RaunakR16/BreathEZ_Auto_CalibratingCPAP/PCB_V0.1/Images/PCB_View_WithComponents.jpg

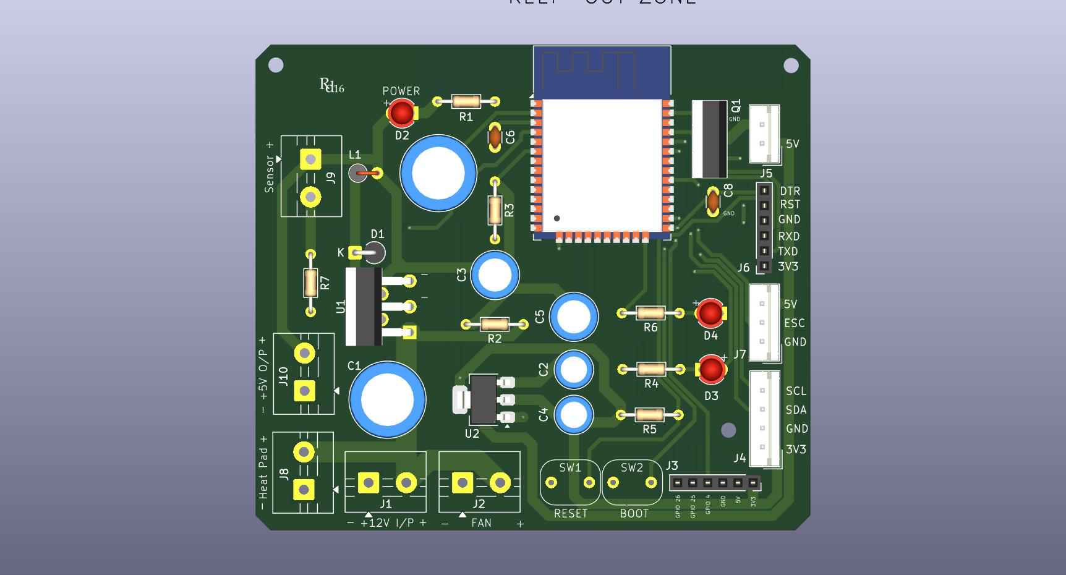
PCB_V0.1/Images/PCB_View_WithComponents.jpg
