RaunakR16/BreathEZ_Auto_CalibratingCPAP/README.md

# BreathEZ
An Auto_CalibratingCPAP
My B.Tech 4th Year project
