RaunakR16/BreathEZ_Auto_CalibratingCPAP/SensorCalibration/SensorData/Grage_1_FilterPaper_17_11_25/sensor_data1.csv

Temperature (°C) | Humidity (%) | Paper Sensor Value
26.20 | 56.00 | 88
26.20 | 57.00 | 0
26.20 | 58.00 | 0
26.20 | 57.00 | 0
26.20 | 57.00 | 57
26.20 | 57.00 | 220
26.20 | 57.00 | 581
26.20 | 57.00 | 1023
26.20 | 58.00 | 1023
26.20 | 58.00 | 1023
26.20 | 58.00 | 1023
26.20 | 58.00 | 878
26.20 | 58.00 | 564
26.20 | 58.00 | 173
26.20 | 58.00 | 0
26.20 | 58.00 | 0
26.20 | 59.00 | 0
26.20 | 59.00 | 42
26.20 | 59.00 | 209
26.20 | 59.00 | 581
26.20 | 60.00 | 1005
26.20 | 60.00 | 1023
26.20 | 61.00 | 1023
26.20 | 61.00 | 1023
26.20 | 62.00 | 927
26.20 | 62.00 | 501
26.20 | 63.00 | 0
26.20 | 64.00 | 0
26.20 | 64.00 | 0
26.20 | 66.00 | 9
26.20 | 68.00 | 87
26.20 | 69.00 | 380
26.20 | 71.00 | 989
26.70 | 73.00 | 1023
26.70 | 75.00 | 1023
26.70 | 77.00 | 1023
26.70 | 79.00 | 1002
26.70 | 81.00 | 580
27.10 | 84.00 | 0
27.10 | 86.00 | 0
27.60 | 89.00 | 0
27.60 | 90.00 | 63
28.00 | 91.00 | 647
28.00 | 92.00 | 1023
28.50 | 93.00 | 1023
28.50 | 94.00 | 1023
28.50 | 95.00 | 614
28.90 | 96.00 | 0
28.90 | 98.00 | 0
29.30 | 98.00 | 0
29.30 | 98.00 | 187
29.80 | 98.00 | 1023
29.80 | 98.00 | 1023
30.20 | 98.00 | 1023
30.20 | 98.00 | 943
30.20 | 98.00 | 9
30.80 | 98.00 | 0
30.80 | 98.00 | 0
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
