RaunakR16/BreathEZ_Auto_CalibratingCPAP/SensorCalibration/SensorData/Grage_1_FilterPaper_17_11_25/sensor_data3.csv

Temperature (°C) | Humidity (%) | Paper Sensor Value
26.20 | 65.00 | 1010
26.20 | 66.00 | 863
26.20 | 67.00 | 595
26.20 | 68.00 | 1023
26.40 | 69.00 | 525
26.50 | 69.00 | 1023
26.70 | 69.00 | 713
26.70 | 69.00 | 812
26.70 | 70.00 | 991
26.70 | 70.00 | 552
26.70 | 70.00 | 1023
26.70 | 71.00 | 529
26.70 | 71.00 | 1023
26.70 | 72.00 | 753
26.70 | 72.00 | 708
26.70 | 73.00 | 1023
26.70 | 73.00 | 473
26.70 | 75.00 | 1023
26.70 | 77.00 | 774
26.70 | 79.00 | 647
26.70 | 81.00 | 1023
27.10 | 83.00 | 573
27.10 | 85.00 | 986
27.10 | 88.00 | 951
27.60 | 90.00 | 638
27.60 | 91.00 | 1023
28.00 | 92.00 | 746
28.50 | 93.00 | 983
28.50 | 94.00 | 1005
28.90 | 95.00 | 771
29.00 | 96.00 | 1023
29.30 | 98.00 | 866
29.80 | 98.00 | 930
29.80 | 98.00 | 1023
29.80 | 98.00 | 821
30.20 | 98.00 | 1023
30.20 | 98.00 | 1011
30.80 | 98.00 | 868
30.80 | 98.00 | 1023
30.80 | 98.00 | 963
30.80 | 98.00 | 922
30.80 | 98.00 | 1023
30.80 | 98.00 | 898
30.80 | 98.00 | 1023
30.80 | 98.00 | 1010
30.70 | 98.00 | 904
30.20 | 98.00 | 1023
30.20 | 98.00 | 912
30.20 | 98.00 | 1001
30.20 | 98.00 | 1023
29.80 | 98.00 | 890
29.80 | 98.00 | 1023
29.80 | 98.00 | 999
29.80 | 98.00 | 910
29.30 | 98.00 | 1023
29.30 | 98.00 | 984
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
