RaunakR16/BreathEZ_Auto_CalibratingCPAP/breathingPatternAnalysis/Graphes/AdrikPaul,M12.png

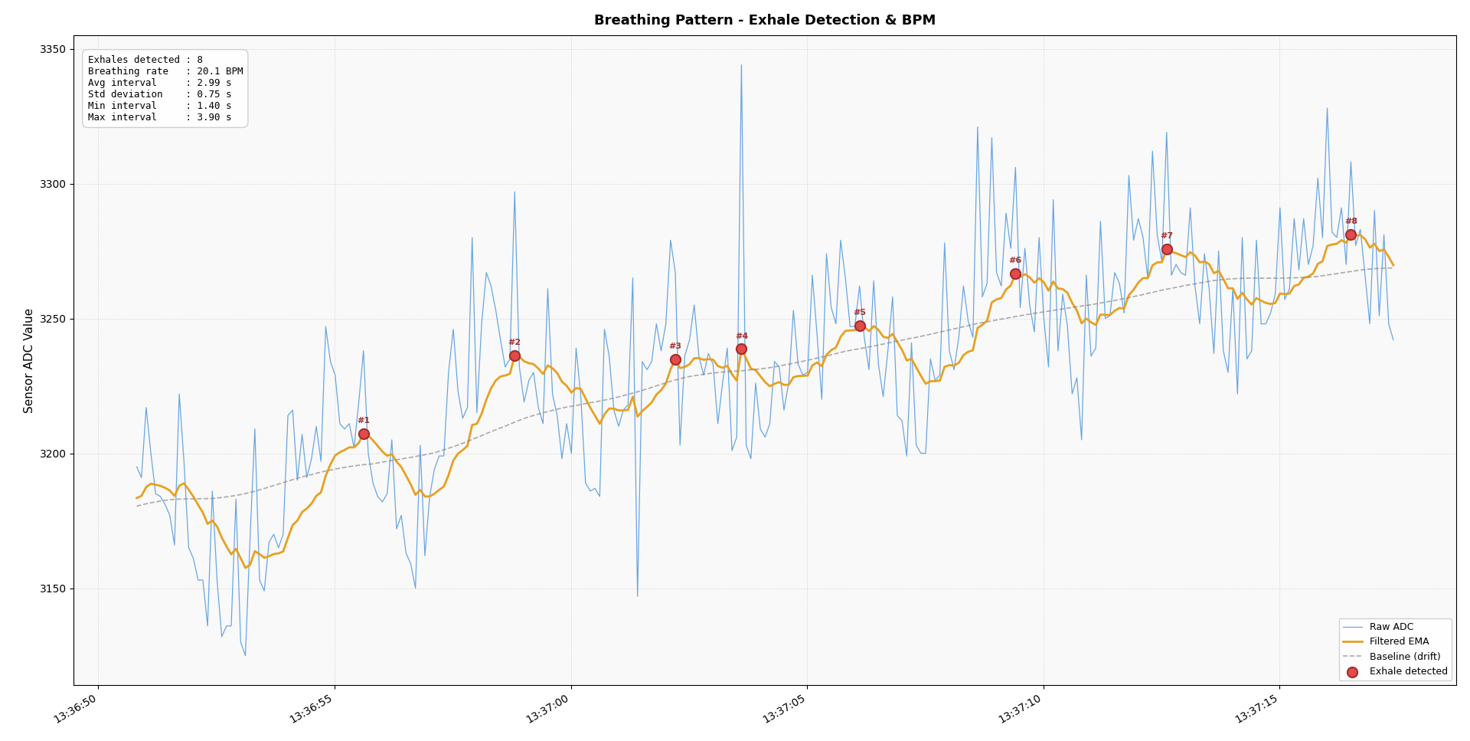
breathingPatternAnalysis/Graphes/AdrikPaul,M12.png
