RaunakR16/BreathEZ_Auto_CalibratingCPAP/breathingPatternAnalysis/Graphes/ArchanaSarkar,F72.png

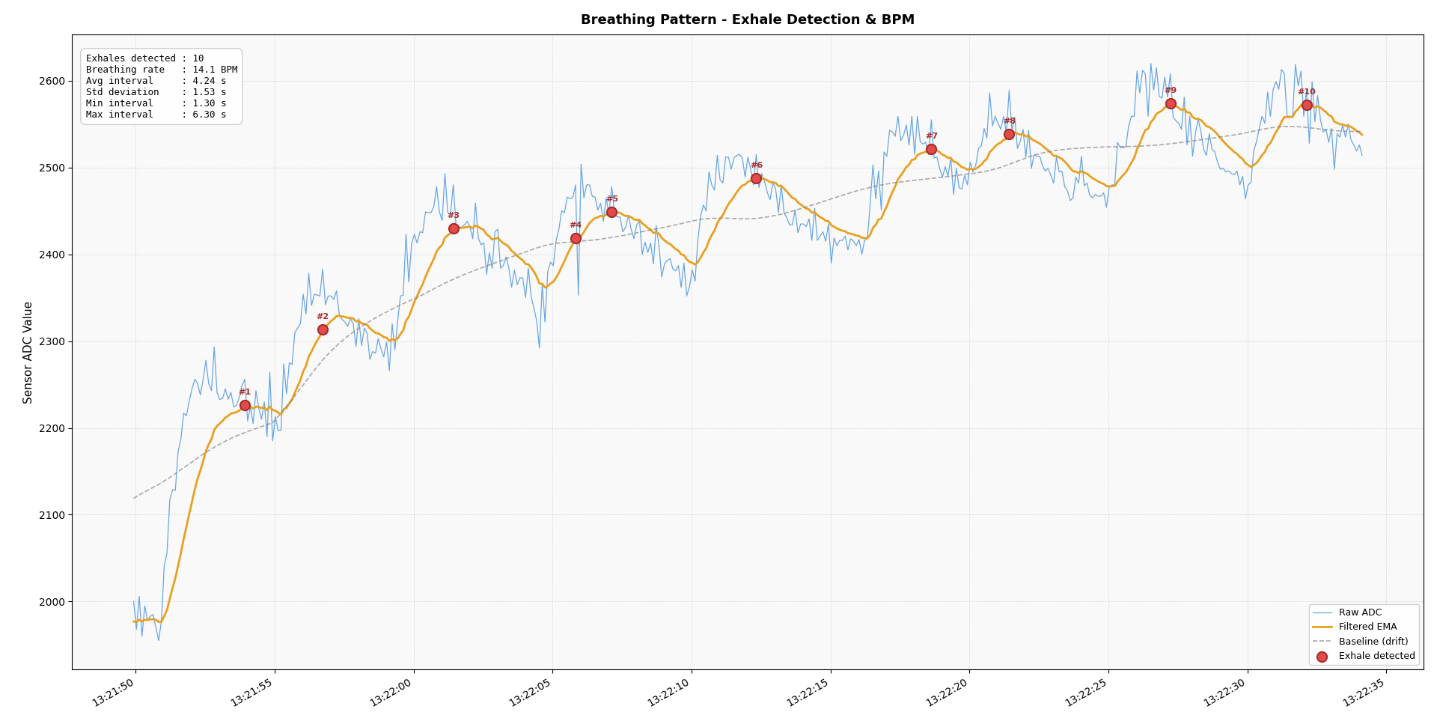
breathingPatternAnalysis/Graphes/ArchanaSarkar,F72.png
