RaunakR16/BreathEZ_Auto_CalibratingCPAP/breathingPatternAnalysis/Graphes/MamppiPaul,F42.png

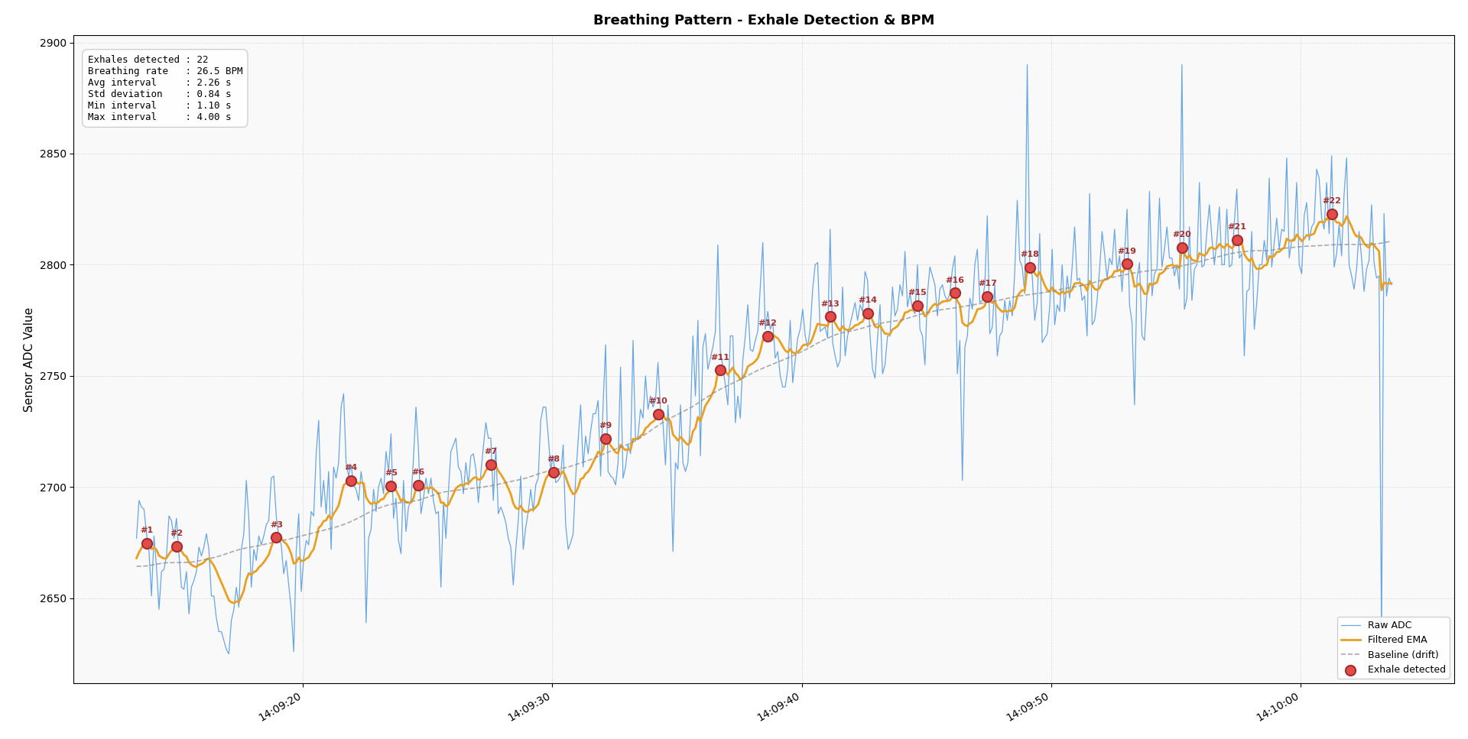
breathingPatternAnalysis/Graphes/MamppiPaul,F42.png
