RaunakR16/BreathEZ_Auto_CalibratingCPAP/breathingPatternAnalysis/Graphes/ProloyPal,M35.png

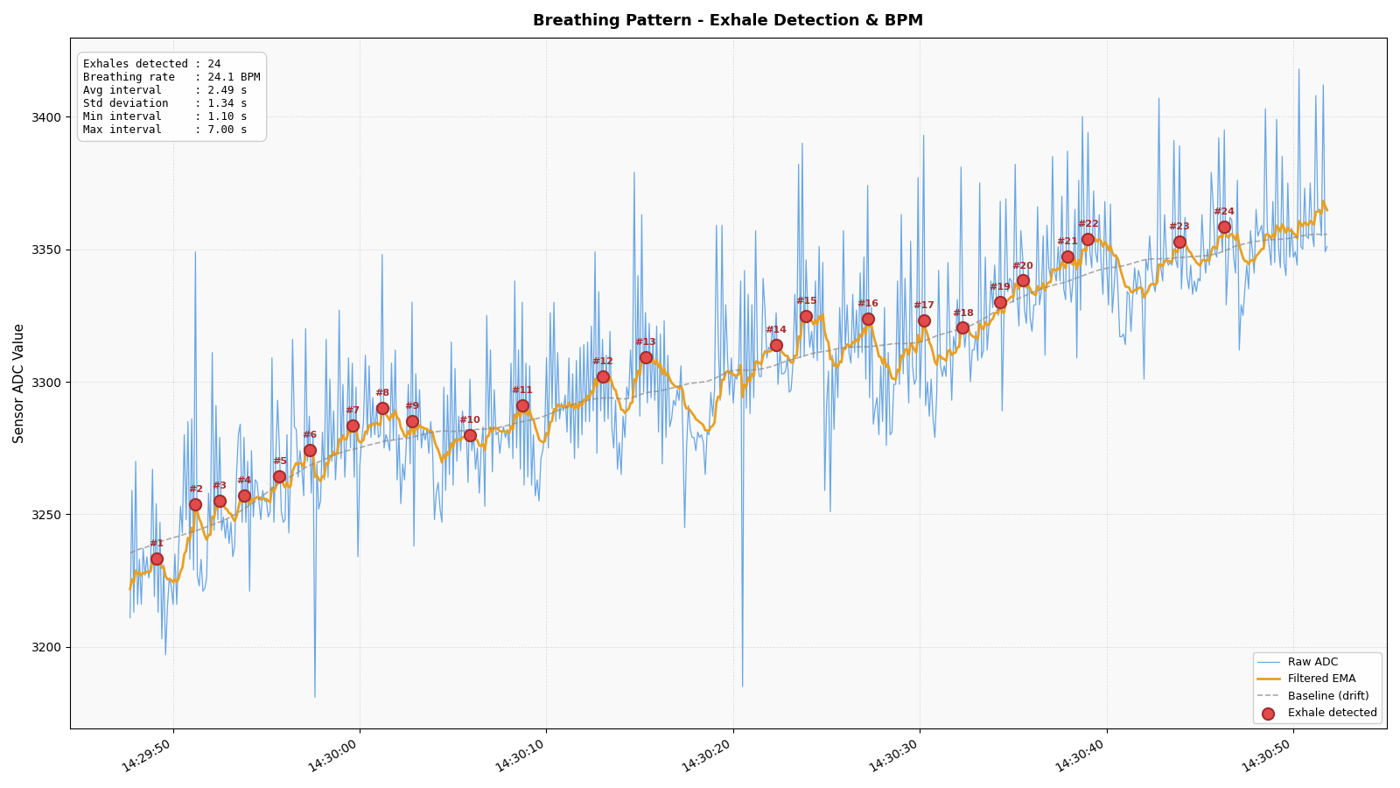
breathingPatternAnalysis/Graphes/ProloyPal,M35.png
