RaunakR16/BreathEZ_Auto_CalibratingCPAP/breathingPatternAnalysis/Graphes/RaunakDas,M22.png

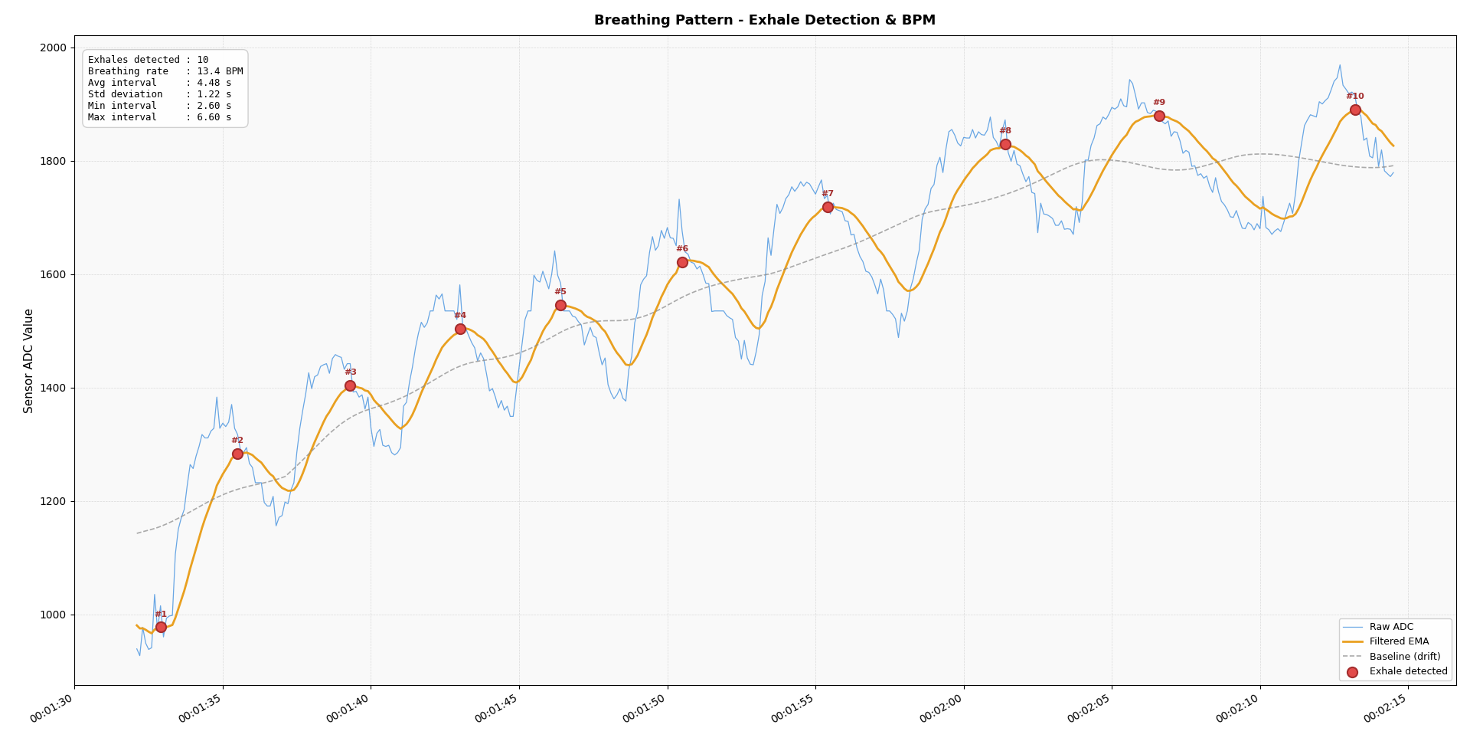
breathingPatternAnalysis/Graphes/RaunakDas,M22.png
