RaunakR16/BreathEZ_Auto_CalibratingCPAP/breathingPatternAnalysis/Graphes/SangitaBhuya,F64.png

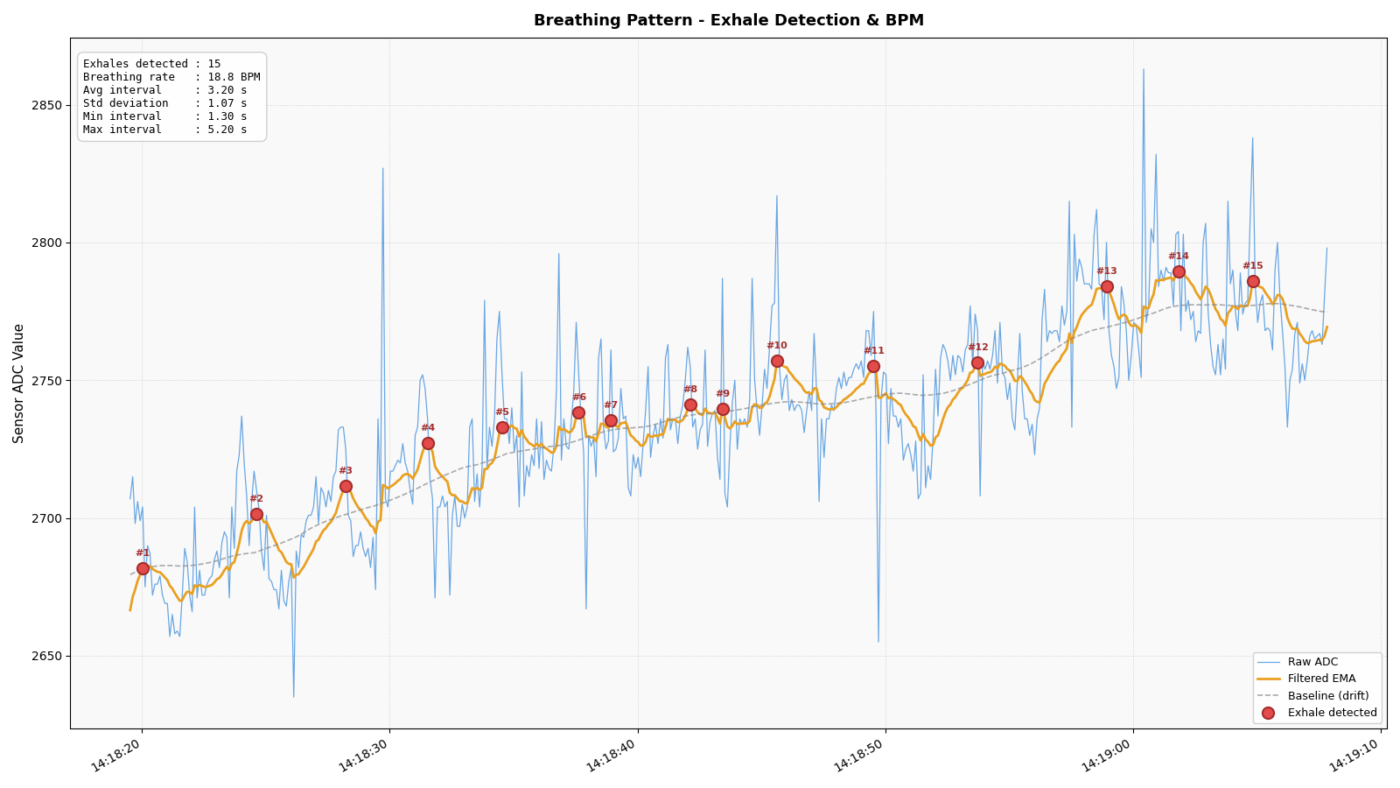
breathingPatternAnalysis/Graphes/SangitaBhuya,F64.png
