RaunakR16/BreathEZ_Auto_CalibratingCPAP/breathingPatternAnalysis/Graphes/SankarPaul,M62.png

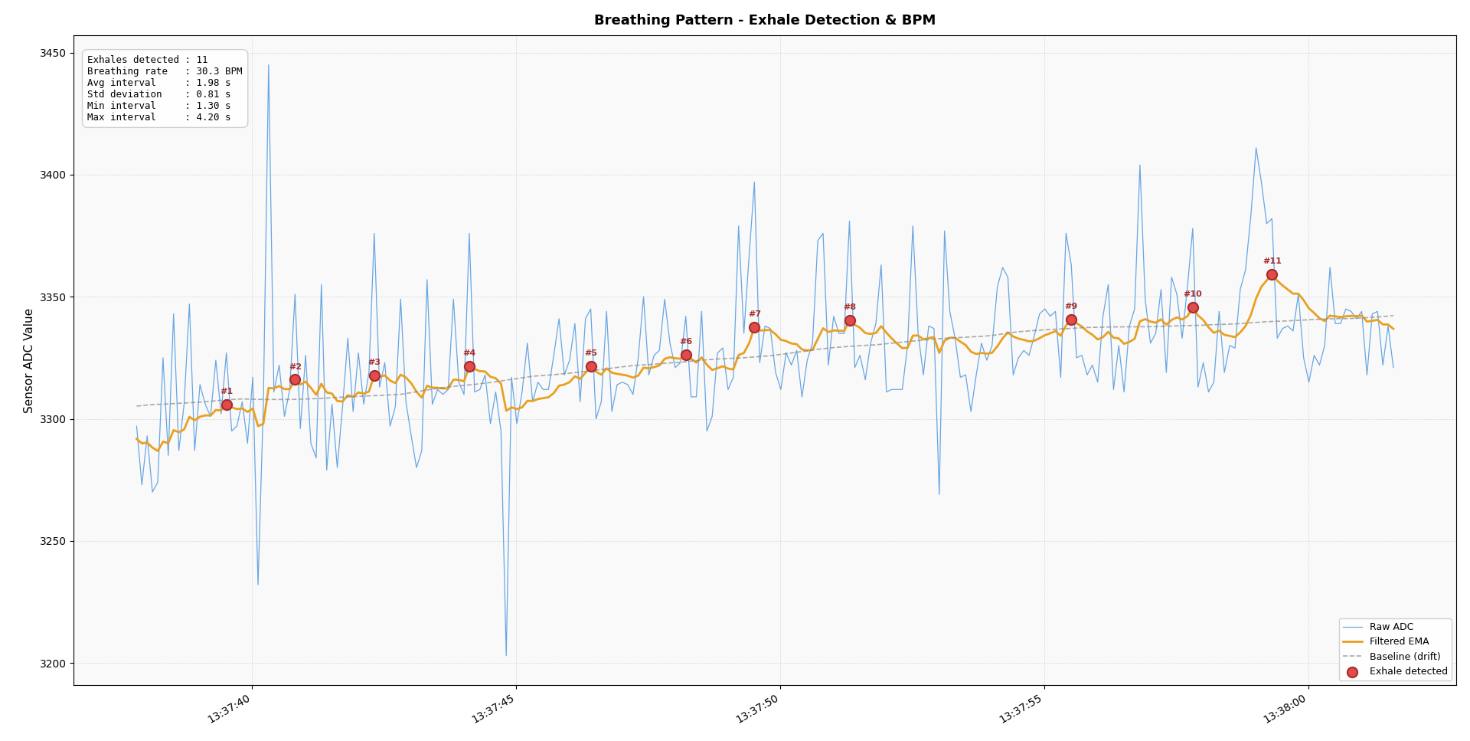
breathingPatternAnalysis/Graphes/SankarPaul,M62.png
