RaunakR16/BreathEZ_Auto_CalibratingCPAP/IMAGES/FlowChart.png

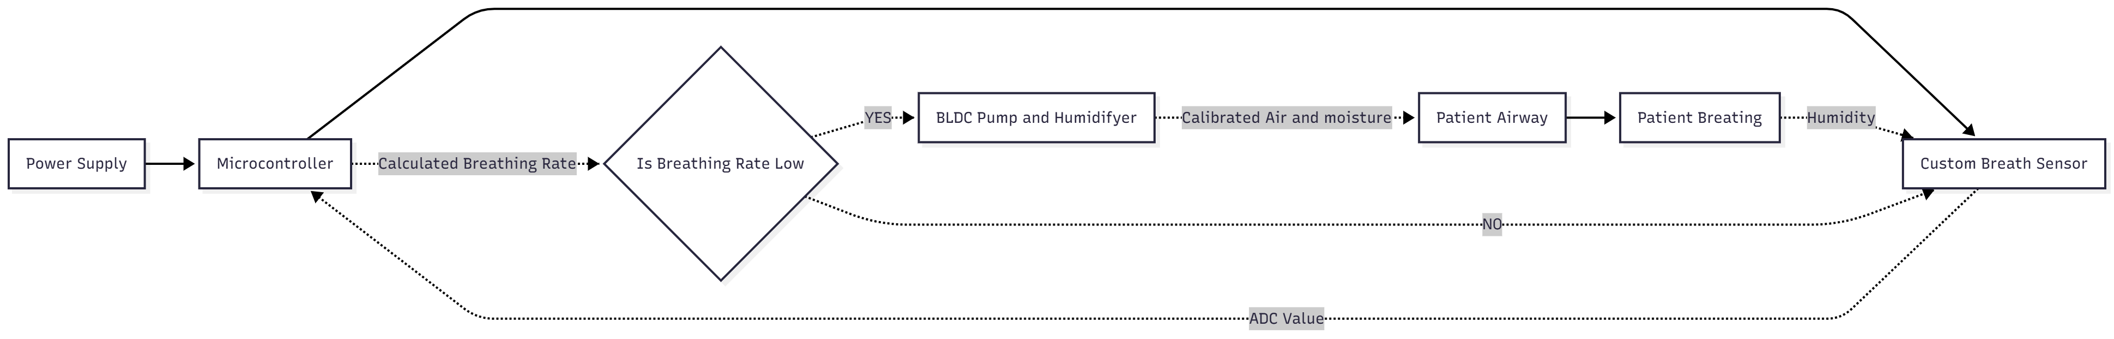
IMAGES/FlowChart.png
