RaunakR16/BreathEZ_Auto_CalibratingCPAP/IMAGES/Graphes/G1HMP.png

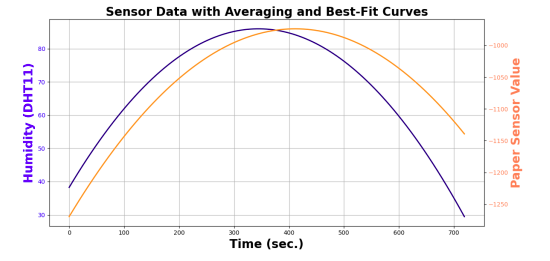
IMAGES/Graphes/G1HMP.png
