RaunakR16/BreathEZ_Auto_CalibratingCPAP/IMAGES/Graphes/G3HMP.png

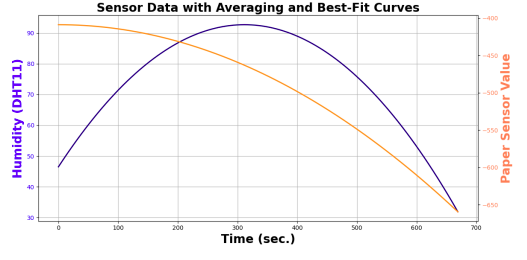
IMAGES/Graphes/G3HMP.png
