RaunakR16/BreathEZ_Auto_CalibratingCPAP/IMAGES/Graphes/G4NP.png

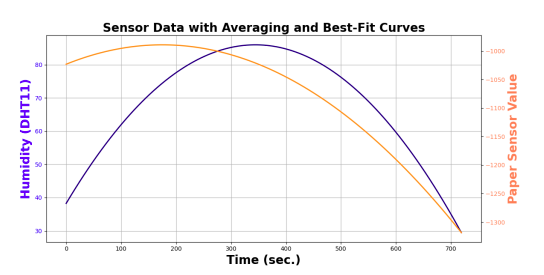
IMAGES/Graphes/G4NP.png
