RaunakR16/BreathEZ_Auto_CalibratingCPAP/IMAGES/Graphes/no heat pad.png

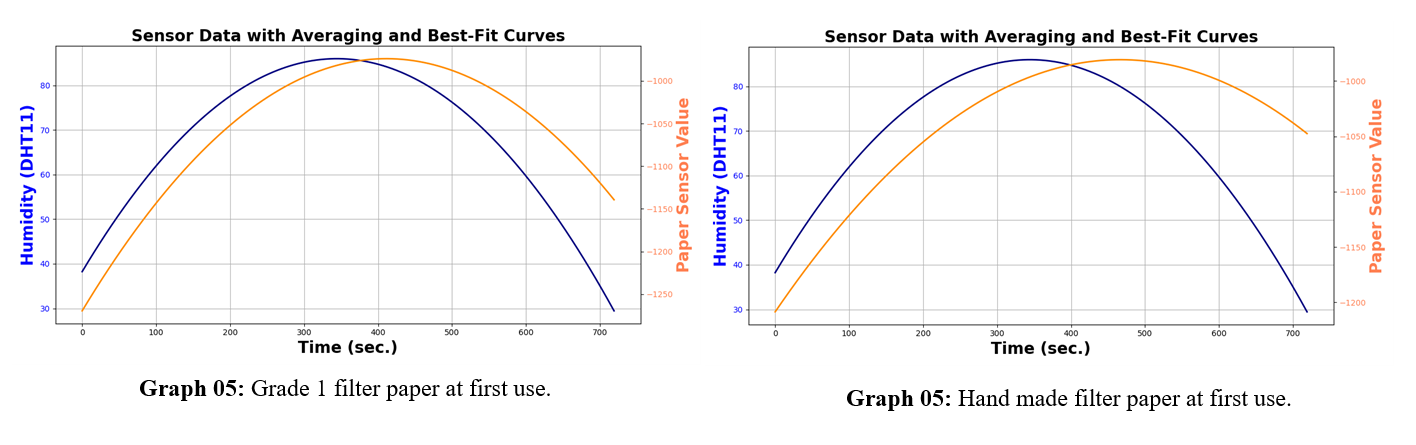
IMAGES/Graphes/no heat pad.png
