RaunakR16/BreathEZ_Auto_CalibratingCPAP/IMAGES/Graphes/Screenshot 2025-11-19 004111.png

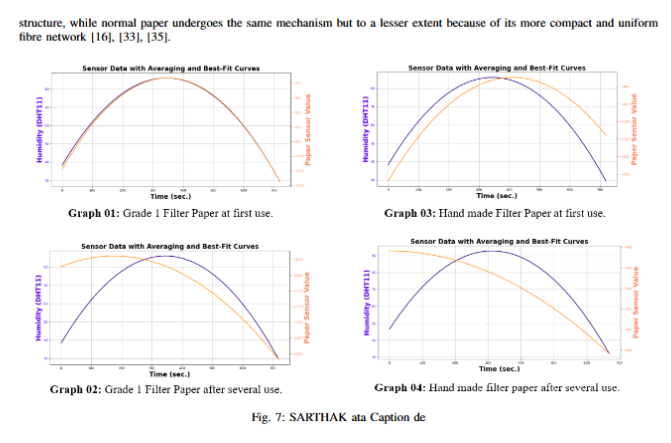
IMAGES/Graphes/Screenshot 2025-11-19 004111.png
