RaunakR16/BreathEZ_Auto_CalibratingCPAP/IMAGES/Graphes/with_heat_Pad.png

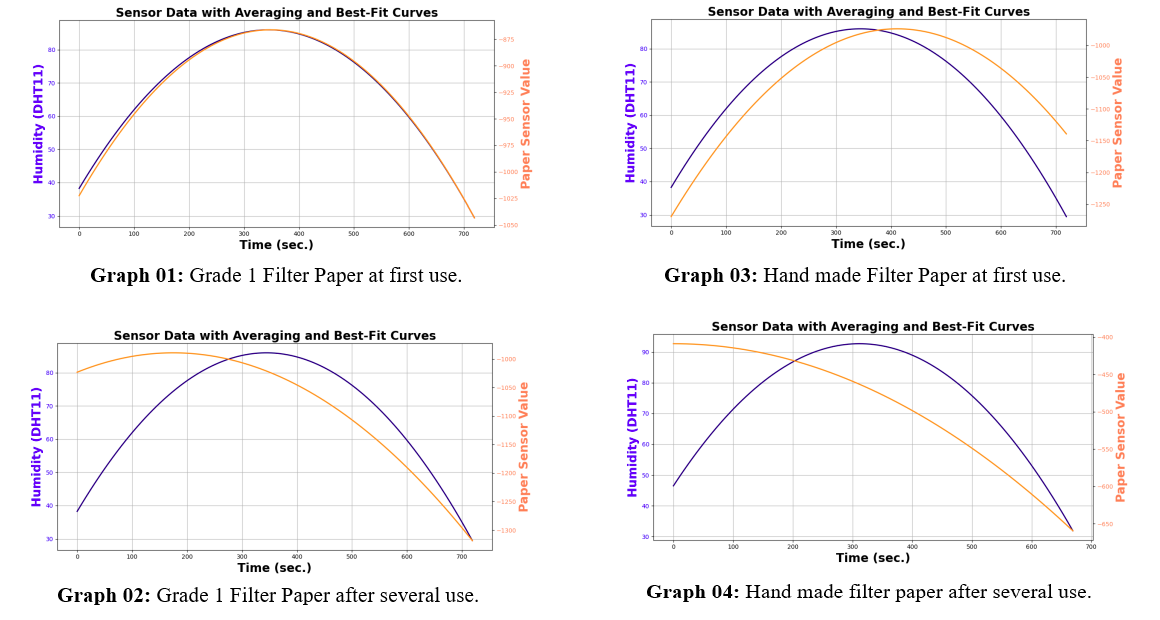
IMAGES/Graphes/with_heat_Pad.png
