RaunakR16/BreathEZ_Auto_CalibratingCPAP/IMAGES/HeatPad.png

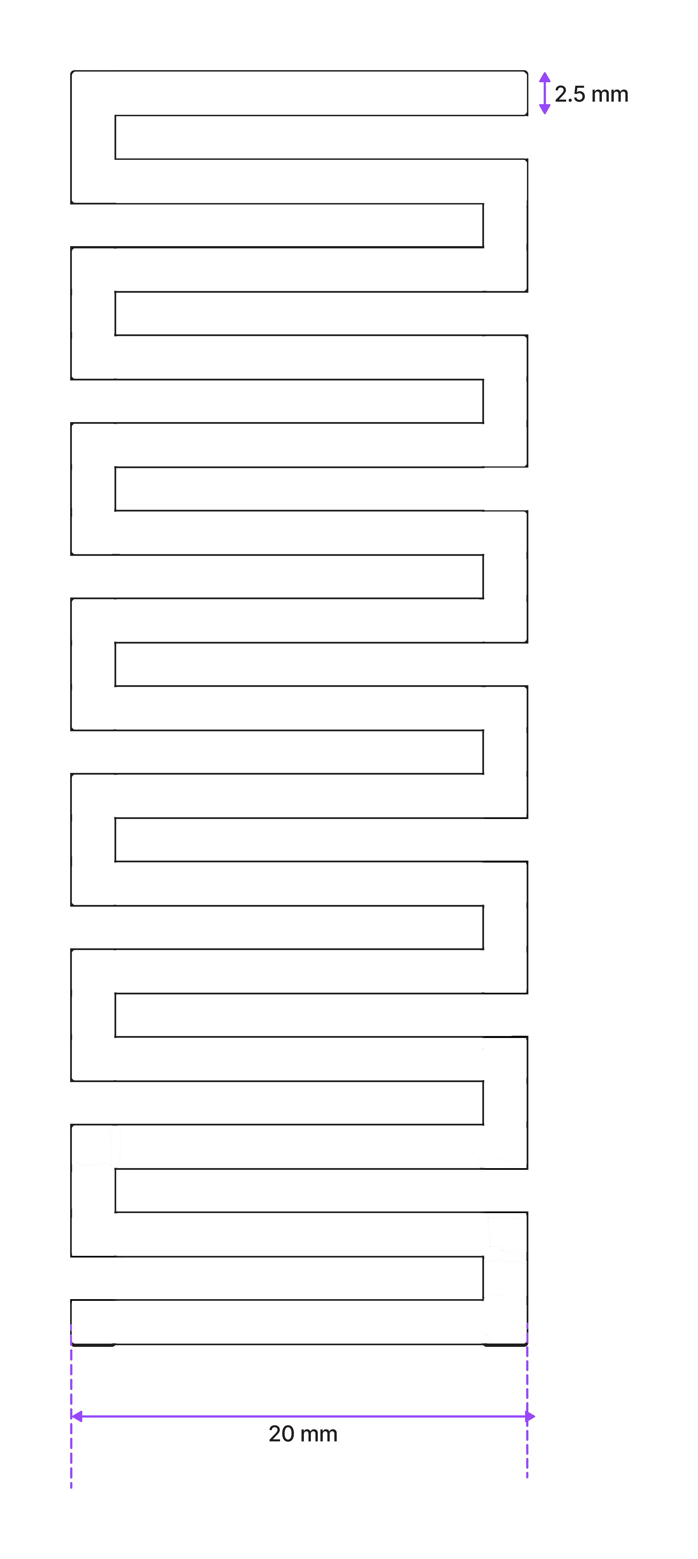
IMAGES/HeatPad.png
