RaunakR16/BreathEZ_Auto_CalibratingCPAP/IMAGES/image.png

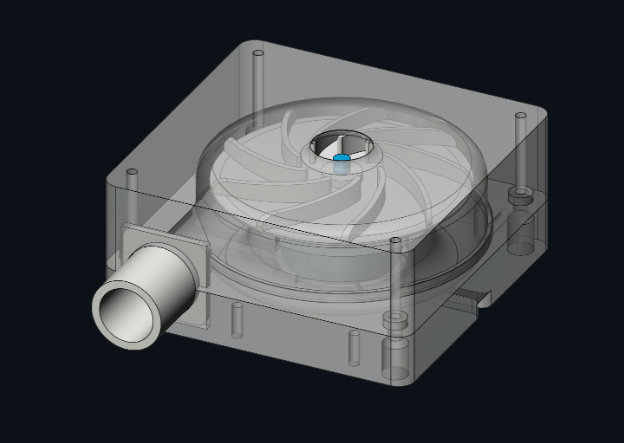
IMAGES/image.png
