RaunakR16/BreathEZ_Auto_CalibratingCPAP/IMAGES/Microscopic_Images/cloth_used/WhatsApp Image 2025-11-13 at 3.08.39 PM (2).jpeg

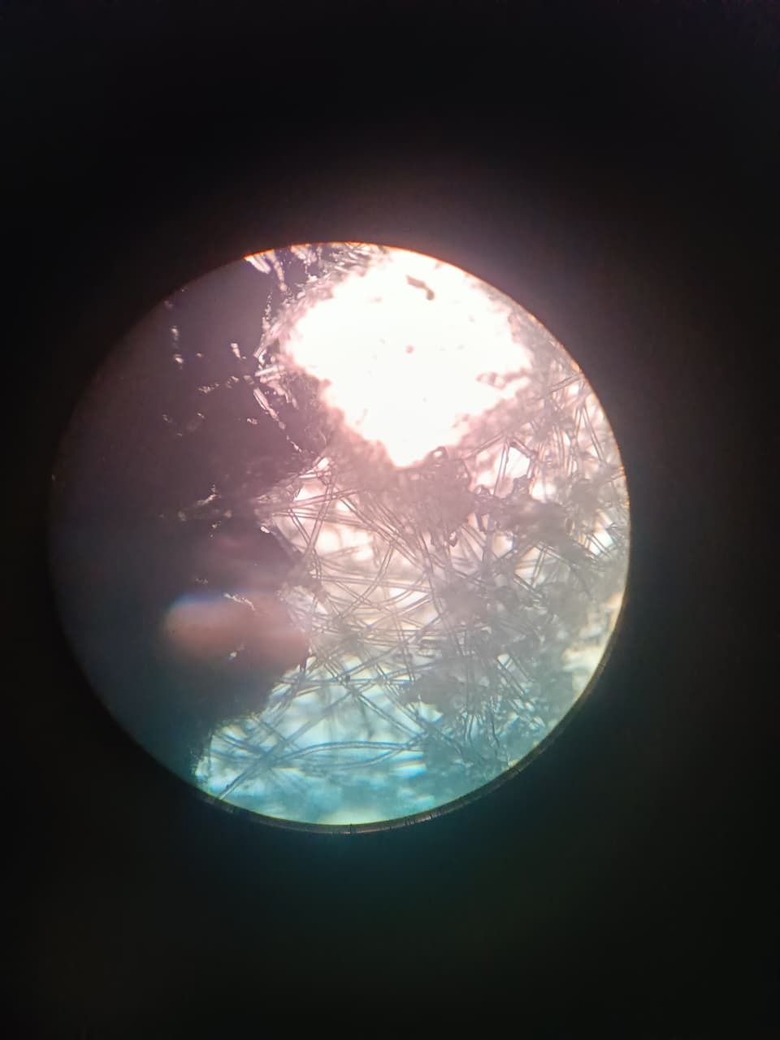
IMAGES/Microscopic_Images/cloth_used/WhatsApp Image 2025-11-13 at 3.08.39 PM (2).jpeg
