RaunakR16/BreathEZ_Auto_CalibratingCPAP/IMAGES/Microscopic_Images/maskpaper_nosalt/WhatsApp Image 2025-11-13 at 3.13.03 PM (1).jpeg

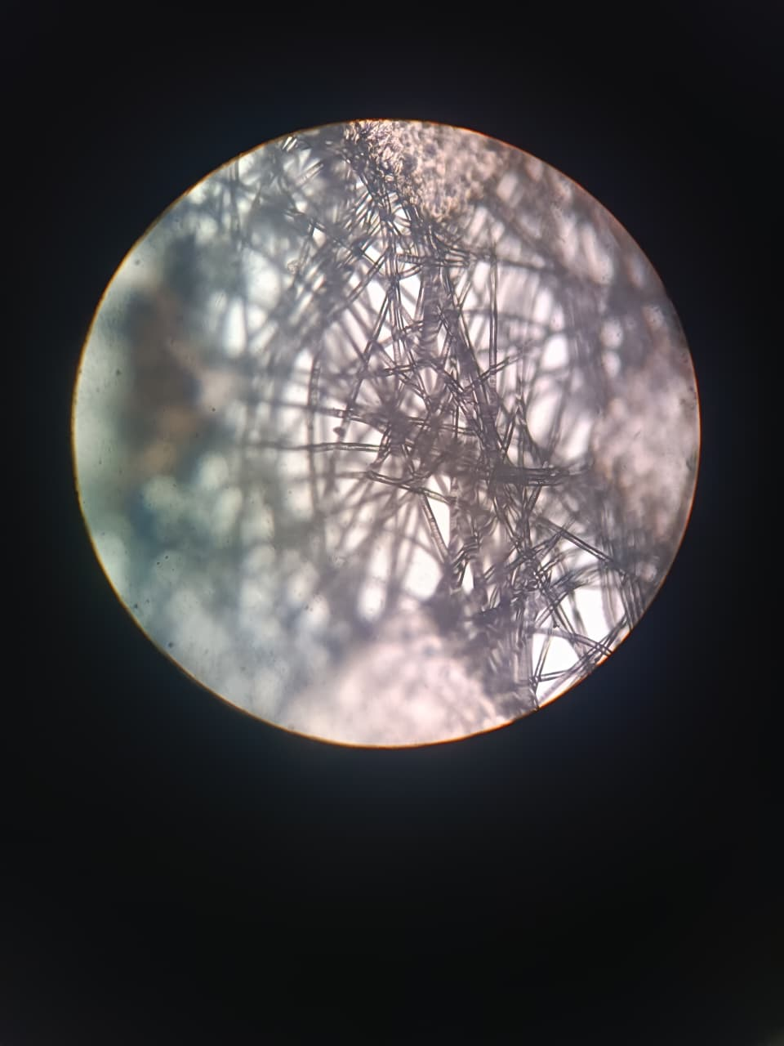
IMAGES/Microscopic_Images/maskpaper_nosalt/WhatsApp Image 2025-11-13 at 3.13.03 PM (1).jpeg
