RaunakR16/BreathEZ_Auto_CalibratingCPAP/IMAGES/Microscopic_Images/used_paper_sensor/WhatsApp Image 2025-11-13 at 3.00.08 PM.jpeg

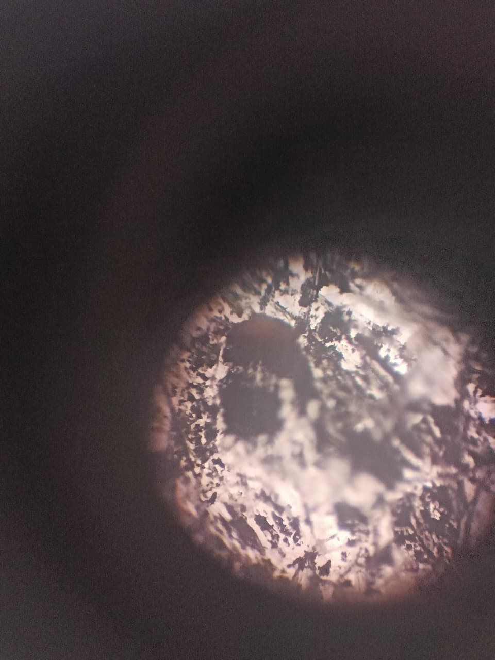
IMAGES/Microscopic_Images/used_paper_sensor/WhatsApp Image 2025-11-13 at 3.00.08 PM.jpeg
