RaunakR16/BreathEZ_Auto_CalibratingCPAP/IMAGES/no_heat_paper/G2_HMP.png

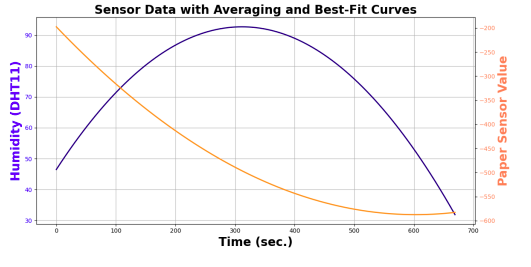
IMAGES/no_heat_paper/G2_HMP.png
