RaunakR16/BreathEZ_Auto_CalibratingCPAP/IMAGES/no_heat_paper/G3NP.png

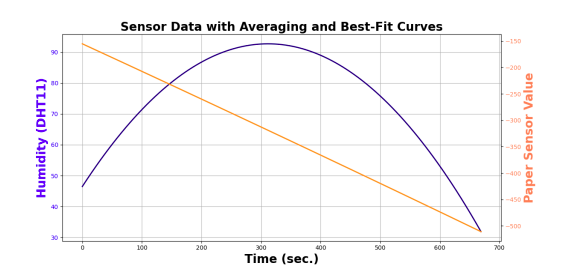
IMAGES/no_heat_paper/G3NP.png
