RaunakR16/BreathEZ_Auto_CalibratingCPAP/IMAGES/no_heat_paper/Graph1_NormalPaper.png

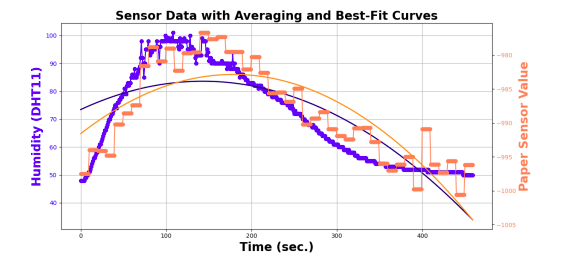
IMAGES/no_heat_paper/Graph1_NormalPaper.png
