RaunakR16/BreathEZ_Auto_CalibratingCPAP/IMAGES/Pump1.png

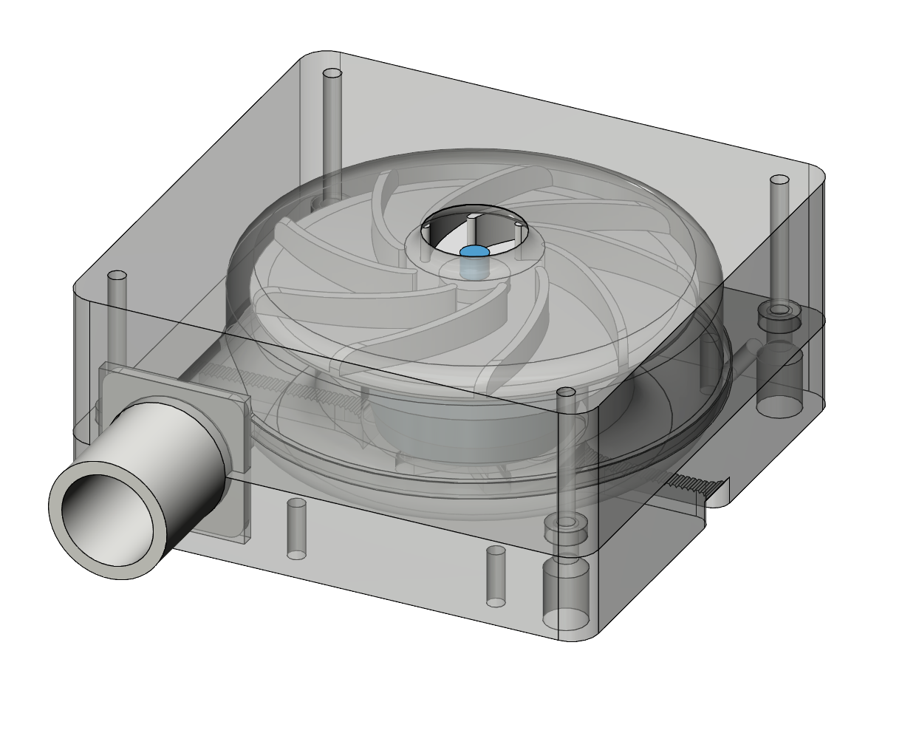
IMAGES/Pump1.png
