RaunakR16/BreathEZ_Auto_CalibratingCPAP/IMAGES/Pump.png

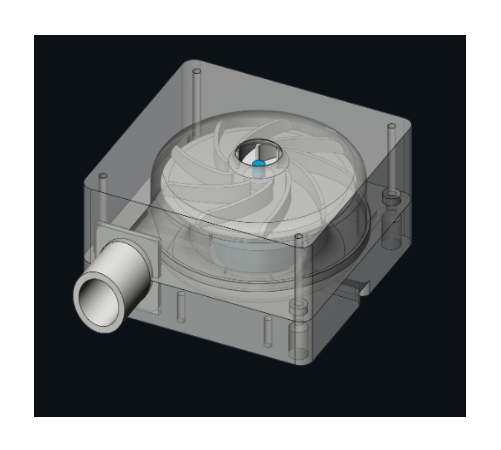
IMAGES/Pump.png
