RaunakR16/BreathEZ_Auto_CalibratingCPAP/IMAGES/tank/tank100.jpg

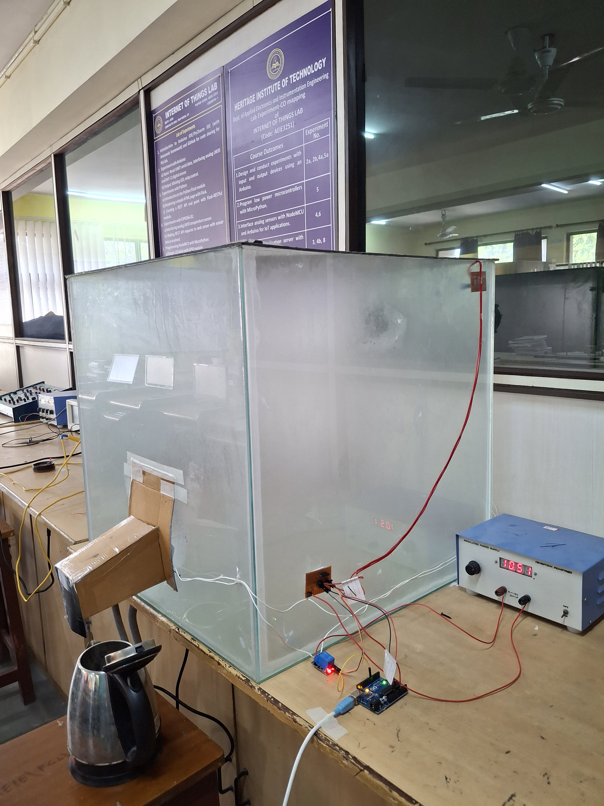
IMAGES/tank/tank100.jpg
