RaunakR16/BreathEZ_Auto_CalibratingCPAP/IMAGES/with_heat_pad/G2NP.png

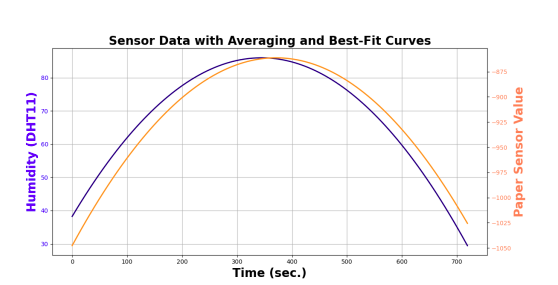
IMAGES/with_heat_pad/G2NP.png
