RaunakR16/BreathEZ_Auto_CalibratingCPAP/PCB_V0.1/Images/ATmega328p_Draft.png

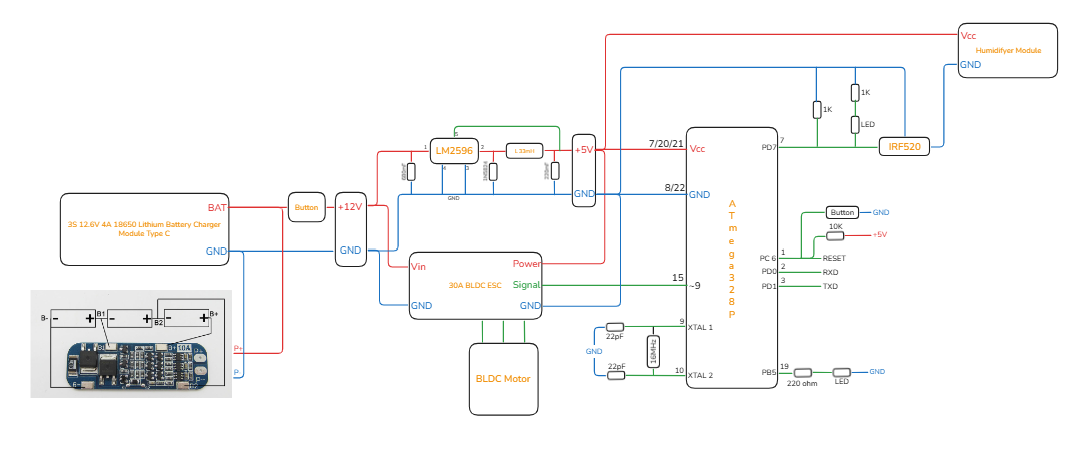
PCB_V0.1/Images/ATmega328p_Draft.png
