RaunakR16/BreathEZ_Auto_CalibratingCPAP/PCB_V0.1/Images/ESP32-WROOM-32_Draft.png

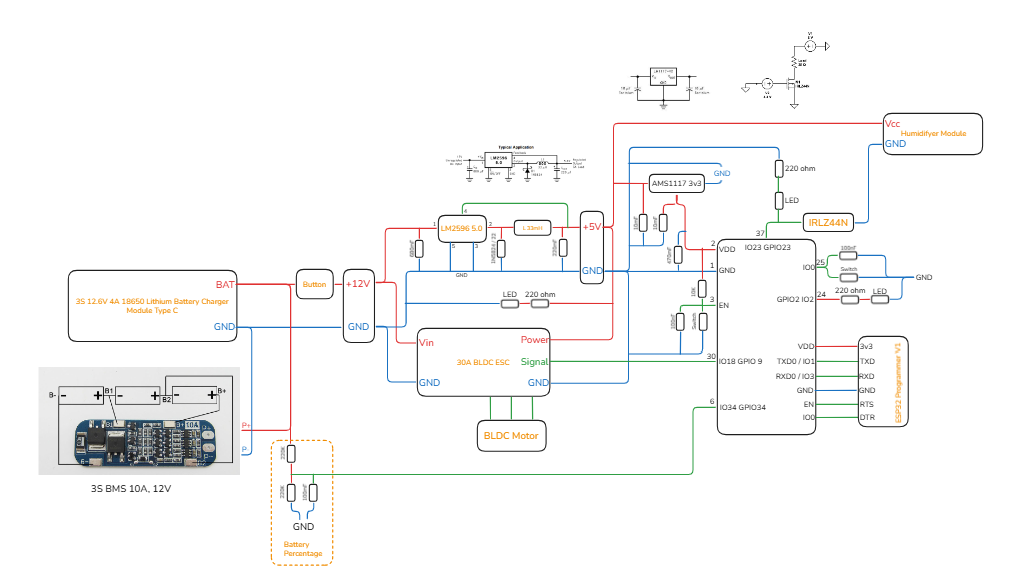
PCB_V0.1/Images/ESP32-WROOM-32_Draft.png
