RaunakR16/BreathEZ_Auto_CalibratingCPAP/PCB_V0.1/Images/PCB_View.jpg

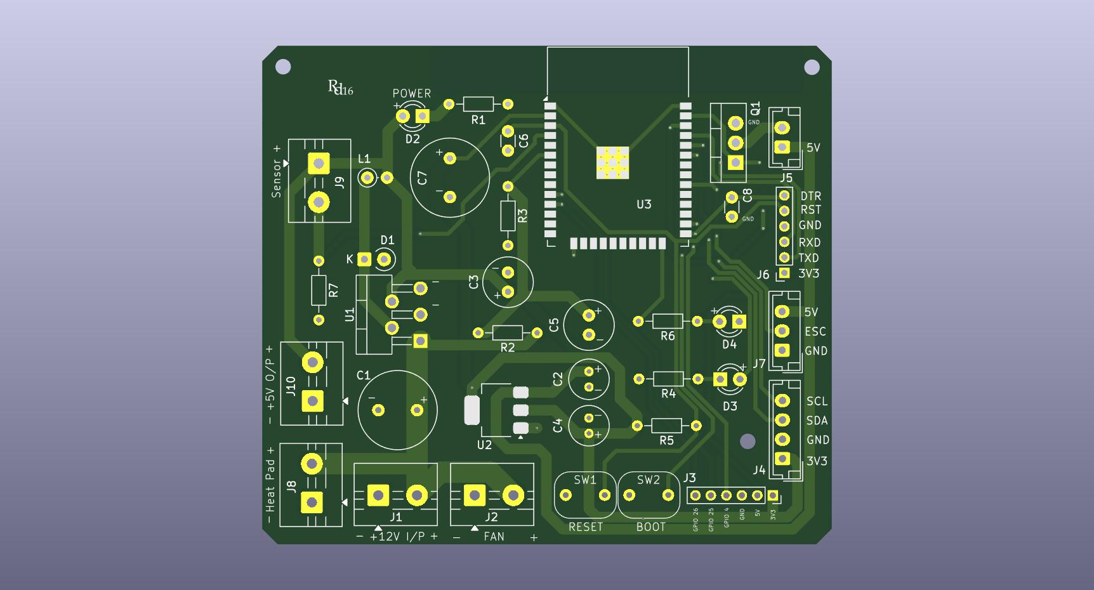
PCB_V0.1/Images/PCB_View.jpg
