RaunakR16/BreathEZ_Auto_CalibratingCPAP/3D Prints/BreathEZ_V1.1/pressure_sensor_assy_HX710B.step

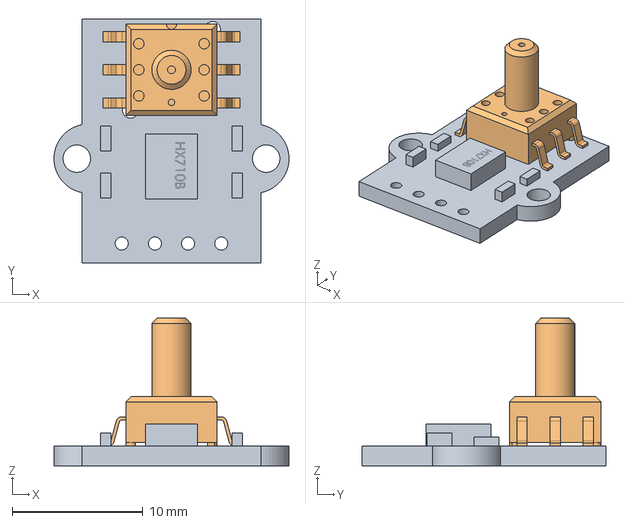
[picture p85: CAD file, 2026-05-27]
3D Prints/BreathEZ_V1.1/pressure_sensor_assy_HX710B.step
18.0 x 18.7 x 11.3 mm
pressure_sensor_pcb_HX710B
MPS-3117_По умолчанию
