RaunakR16/BreathEZ_Auto_CalibratingCPAP/3D Prints/BreathEZ_V1.1/Pantalla OLED 0.96'' 128x64.step

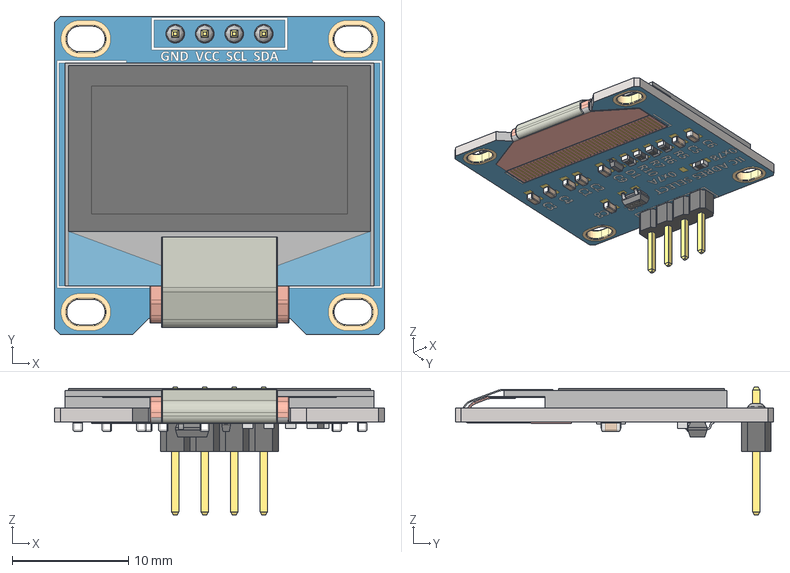
[picture p86: CAD file, 2026-05-27]
3D Prints/BreathEZ_V1.1/Pantalla OLED 0.96'' 128x64.step
28.4 x 27.4 x 11.0 mm
SOT-23_TOR
RES_CR16_MTK_1 x 4
RES_CR16_MTK
SOD323F_DIO
