RaunakR16/BreathEZ_Auto_CalibratingCPAP/3D Prints/BreathEZ_V1.1/4S BMS Charger.step

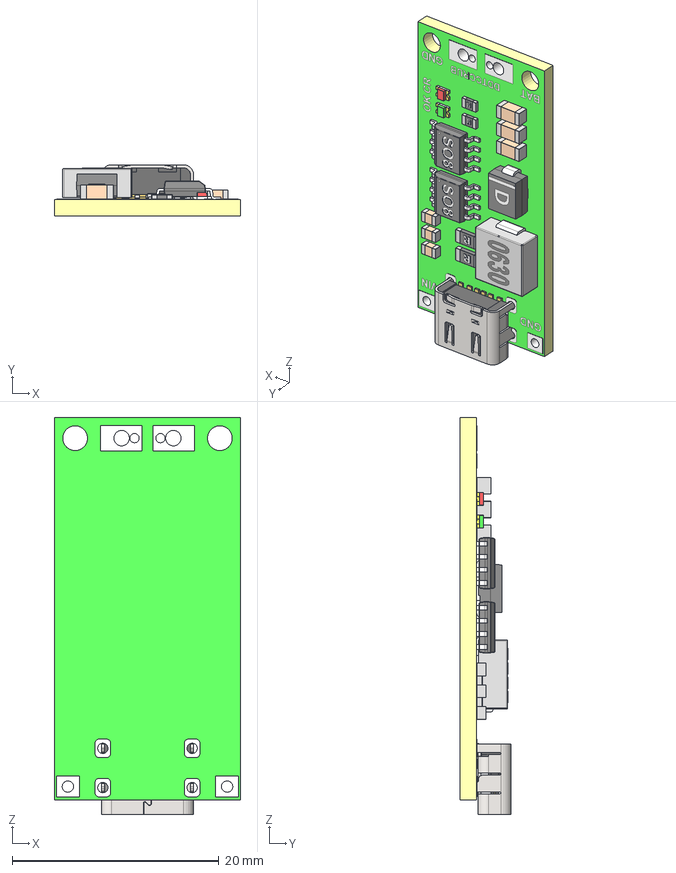
[picture p87: CAD file, 2026-05-27]
3D Prints/BreathEZ_V1.1/4S BMS Charger.step
18.0 x 4.98 x 38.4 mm
