RaunakR16/BreathEZ_Auto_CalibratingCPAP/3D Prints/BreathEZ_V1.1/Hold_21700-4p.step

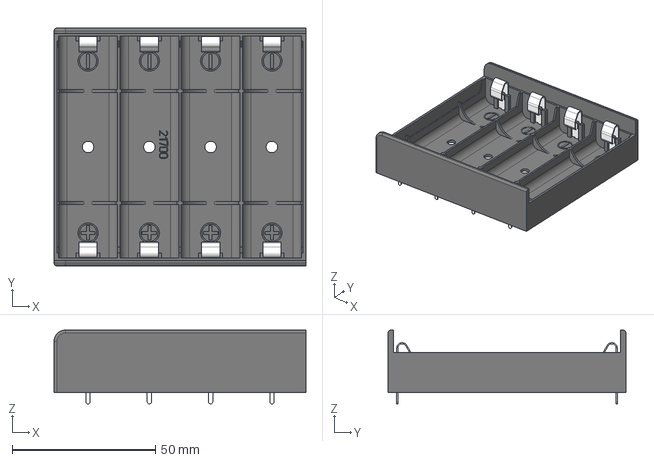
[picture p88: CAD file, 2026-05-27]
3D Prints/BreathEZ_V1.1/Hold_21700-4p.step
88.0 x 83.0 x 25.8 mm
Hold_21700_Con x 8
Hold_21700-4p
