RaunakR16/BreathEZ_Auto_CalibratingCPAP/3D Prints/BreathEZ_V1.1/Button.step

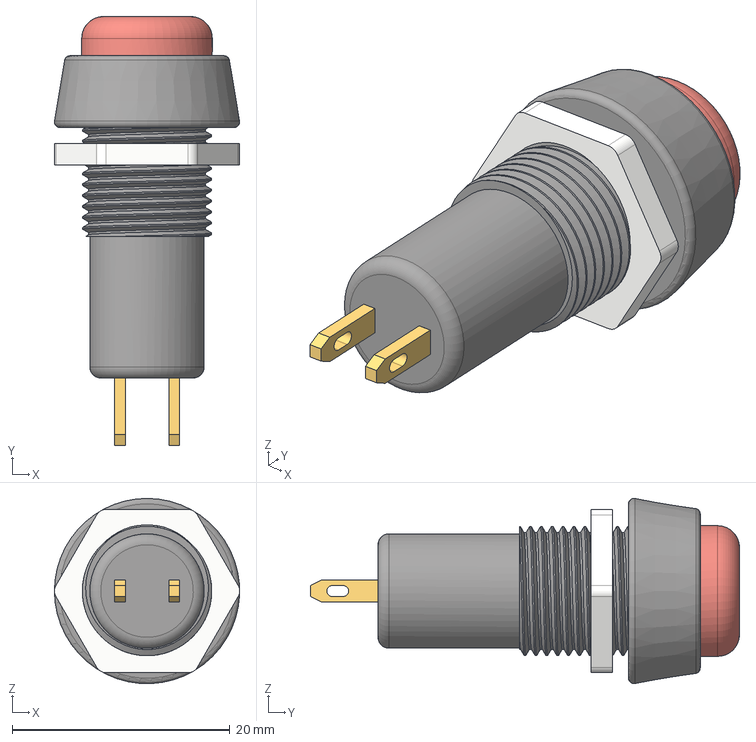
[picture p89: CAD file, 2026-05-27]
3D Prints/BreathEZ_V1.1/Button.step
17.0 x 39.4 x 17.0 mm
