RaunakR16/BreathEZ_Auto_CalibratingCPAP/3D Prints/BreathEZ_V1.1/BLDC_Pump.step

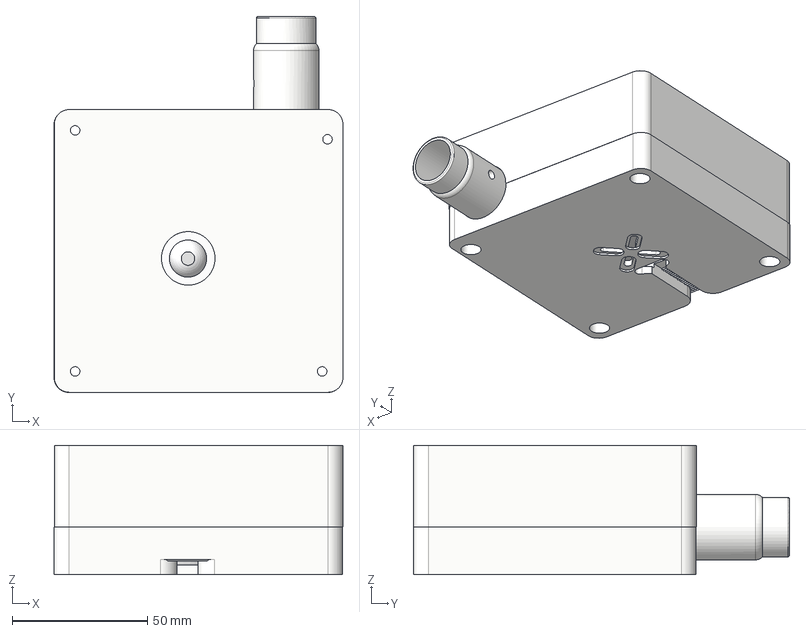
[picture p90: CAD file, 2026-05-27]
3D Prints/BreathEZ_V1.1/BLDC_Pump.step
106.8 x 139.0 x 47.7 mm
