RaunakR16/BreathEZ_Auto_CalibratingCPAP/3D Prints/BreathEZ_V1.0/BLDC_Pump.step

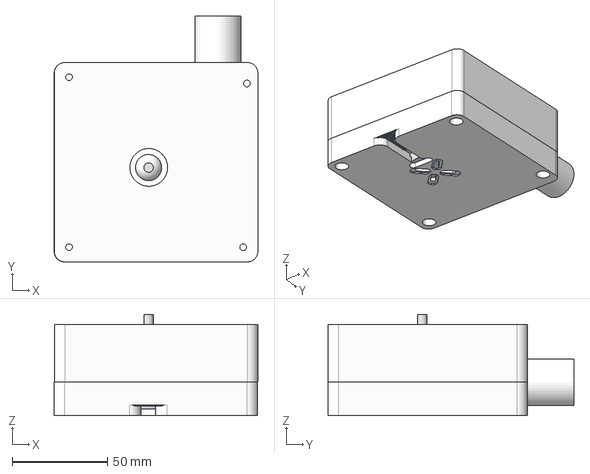
[picture p91: CAD file, 2026-05-27, an earlier design]
3D Prints/BreathEZ_V1.0/BLDC_Pump.step
106.8 x 129.0 x 53.1 mm
