RaunakR16/BreathEZ_Auto_CalibratingCPAP/SensorCalibration/SensorData/Garbeg_data/Data_MaskMeterial(polypropylene)_17.11.2025/sensor.csv

Temperature (°C) | Humidity (%) | Paper Sensor Value
25.80 | 56.00 | 10
25.80 | 56.00 | 6
25.80 | 56.00 | 9
25.80 | 56.00 | 9
25.80 | 56.00 | 7
25.80 | 56.00 | 8
25.80 | 56.00 | 8
25.80 | 56.00 | 8
25.80 | 56.00 | 9
