RaunakR16/BreathEZ_Auto_CalibratingCPAP/SensorCalibration/SensorData/Data_MaskMeterial(polypropylene)_11.11.2025/sensor_data_2.csv

Temperature (°C) | Humidity (%) | Paper Sensor Value
25.30 | 44.00 | 846
25.30 | 43.00 | 846
25.30 | 43.00 | 845
25.30 | 43.00 | 844
25.30 | 43.00 | 845
25.30 | 43.00 | 845
25.30 | 43.00 | 845
25.30 | 44.00 | 844
25.30 | 44.00 | 844
25.30 | 45.00 | 844
25.30 | 47.00 | 843
25.30 | 48.00 | 841
25.30 | 49.00 | 842
25.30 | 51.00 | 841
25.30 | 53.00 | 842
25.30 | 55.00 | 841
25.30 | 58.00 | 841
25.30 | 61.00 | 841
25.30 | 64.00 | 841
25.30 | 68.00 | 841
25.60 | 70.00 | 841
25.80 | 73.00 | 841
25.80 | 76.00 | 839
25.80 | 78.00 | 839
26.20 | 81.00 | 842
24.80 | 46.00 | 981
24.80 | 46.00 | 979
24.80 | 46.00 | 980
24.80 | 45.00 | 980
24.80 | 45.00 | 977
24.80 | 45.00 | 979
24.80 | 45.00 | 980
24.80 | 46.00 | 980
24.80 | 46.00 | 979
24.80 | 47.00 | 978
24.80 | 48.00 | 979
24.90 | 48.00 | 978
25.30 | 49.00 | 977
25.30 | 50.00 | 980
25.30 | 51.00 | 978
25.30 | 52.00 | 977
25.30 | 54.00 | 975
25.30 | 70.00 | 986
25.80 | 74.00 | 984
25.80 | 77.00 | 983
25.80 | 80.00 | 983
26.20 | 82.00 | 982
26.20 | 85.00 | 981
26.20 | 87.00 | 979
26.70 | 89.00 | 978
26.70 | 91.00 | 995
27.10 | 92.00 | 999
27.10 | 93.00 | 999
27.60 | 94.00 | 998
28.00 | 94.00 | 998
28.00 | 95.00 | 995
28.50 | 96.00 | 995
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
