RaunakR16/BreathEZ_Auto_CalibratingCPAP/SensorCalibration/SensorData/Data_MaskMeterial(polypropylene)_11.11.2025/sensor_data_3ok.csv

Temperature (°C) | Humidity (%) | Paper Sensor Value
25.30 | 43.00 | 984
25.30 | 43.00 | 985
25.30 | 43.00 | 984
25.30 | 43.00 | 985
25.30 | 43.00 | 983
25.30 | 43.00 | 984
25.30 | 43.00 | 984
25.30 | 43.00 | 985
25.30 | 43.00 | 983
25.30 | 43.00 | 985
25.30 | 43.00 | 985
25.30 | 43.00 | 984
25.30 | 43.00 | 983
25.30 | 43.00 | 985
25.30 | 44.00 | 984
25.30 | 44.00 | 984
25.30 | 44.00 | 985
25.30 | 44.00 | 985
25.30 | 45.00 | 984
25.30 | 45.00 | 984
25.30 | 46.00 | 984
25.30 | 47.00 | 985
25.30 | 47.00 | 984
25.30 | 48.00 | 985
25.30 | 48.00 | 984
25.30 | 49.00 | 986
25.30 | 50.00 | 985
25.30 | 51.00 | 986
25.30 | 52.00 | 985
25.30 | 53.00 | 984
25.30 | 54.00 | 983
25.30 | 56.00 | 983
25.30 | 58.00 | 982
25.30 | 60.00 | 983
25.80 | 64.00 | 982
25.80 | 68.00 | 981
25.80 | 71.00 | 978
25.80 | 73.00 | 977
26.20 | 77.00 | 975
26.20 | 81.00 | 974
26.70 | 85.00 | 972
26.70 | 89.00 | 969
27.10 | 92.00 | 989
27.60 | 93.00 | 994
27.60 | 94.00 | 993
28.00 | 95.00 | 992
28.00 | 95.00 | 992
28.50 | 98.00 | 992
28.90 | 98.00 | 991
29.30 | 98.00 | 991
29.70 | 98.00 | 990
29.80 | 98.00 | 987
30.20 | 98.00 | 986
30.80 | 98.00 | 986
31.30 | 98.00 | 982
31.80 | 98.00 | 981
31.80 | 98.00 | 978
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
