RaunakR16/BreathEZ_Auto_CalibratingCPAP/SensorCalibration/SensorData/Data_MaskMeterial(polypropylene)_11.11.2025/sensor_data_4.csv

Temperature (°C) | Humidity (%) | Paper Sensor Value
24.90 | 43.00 | 205
24.90 | 43.00 | 149
24.90 | 42.00 | 0
24.80 | 42.00 | 204
24.80 | 42.00 | 0
24.90 | 42.00 | 114
24.80 | 42.00 | 161
24.80 | 42.00 | 0
24.80 | 43.00 | 181
24.80 | 43.00 | 0
24.80 | 43.00 | 75
24.80 | 43.00 | 223
24.80 | 43.00 | 0
24.80 | 43.00 | 246
24.80 | 43.00 | 0
24.90 | 44.00 | 19
24.90 | 44.00 | 221
24.90 | 44.00 | 0
25.10 | 44.00 | 232
25.30 | 45.00 | 21
25.30 | 45.00 | 5
25.30 | 46.00 | 220
25.30 | 46.00 | 0
25.30 | 47.00 | 231
25.30 | 47.00 | 120
25.30 | 48.00 | 0
25.30 | 49.00 | 223
25.30 | 49.00 | 0
25.30 | 51.00 | 48
25.30 | 53.00 | 219
25.30 | 54.00 | 0
25.30 | 58.00 | 234
25.30 | 62.00 | 143
25.30 | 65.00 | 0
25.30 | 69.00 | 226
25.80 | 72.00 | 0
25.80 | 75.00 | 100
25.80 | 78.00 | 178
26.20 | 81.00 | 0
26.20 | 85.00 | 173
26.70 | 88.00 | 78
26.70 | 90.00 | 23
27.10 | 92.00 | 73
27.10 | 93.00 | 0
27.60 | 94.00 | 18
27.60 | 96.00 | 46
27.60 | 96.00 | 0
27.60 | 97.00 | 20
28.00 | 96.00 | 33
27.70 | 98.00 | 0
27.60 | 98.00 | 21
27.60 | 98.00 | 18
27.60 | 98.00 | 0
27.60 | 98.00 | 26
27.20 | 98.00 | 7
27.10 | 98.00 | 4
27.10 | 98.00 | 0
26.70 | 98.00 | 3
26.70 | 98.00 | 15
26.70 | 98.00 | 0
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
