RaunakR16/BreathEZ_Auto_CalibratingCPAP/SensorCalibration/SensorData/Garbeg_data/sensor_data_5.csv

Temperature (°C) | Humidity (%) | Paper Sensor Value
25.30 | 41.00 | 914
25.30 | 41.00 | 919
25.30 | 41.00 | 919
25.30 | 41.00 | 911
25.30 | 42.00 | 914
25.30 | 42.00 | 914
25.30 | 42.00 | 70
25.30 | 42.00 | 0
25.30 | 42.00 | 152
25.30 | 42.00 | 0
25.30 | 42.00 | 160
25.30 | 43.00 | 0
25.30 | 43.00 | 147
25.30 | 43.00 | 70
25.30 | 43.00 | 0
25.30 | 43.00 | 144
25.30 | 44.00 | 0
25.30 | 44.00 | 153
25.30 | 44.00 | 0
25.30 | 44.00 | 921
25.30 | 45.00 | 966
25.30 | 45.00 | 966
25.30 | 46.00 | 966
25.30 | 47.00 | 967
25.30 | 47.00 | 967
25.30 | 48.00 | 967
25.30 | 48.00 | 965
25.30 | 49.00 | 965
25.30 | 51.00 | 966
25.30 | 53.00 | 965
25.30 | 55.00 | 965
25.60 | 58.00 | 964
25.80 | 62.00 | 965
25.80 | 65.00 | 967
25.80 | 69.00 | 965
25.80 | 71.00 | 965
25.80 | 73.00 | 965
25.80 | 75.00 | 964
26.20 | 77.00 | 965
26.20 | 80.00 | 966
26.20 | 82.00 | 965
26.20 | 85.00 | 963
26.70 | 88.00 | 961
26.70 | 90.00 | 960
27.10 | 91.00 | 984
27.10 | 93.00 | 985
27.10 | 93.00 | 985
27.20 | 94.00 | 986
27.60 | 95.00 | 985
27.60 | 96.00 | 985
27.60 | 96.00 | 985
27.60 | 97.00 | 985
27.60 | 98.00 | 984
27.60 | 98.00 | 986
27.60 | 98.00 | 985
27.60 | 98.00 | 987
27.60 | 98.00 | 986
27.60 | 98.00 | 987
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
