RaunakR16/BreathEZ_Auto_CalibratingCPAP/SensorCalibration/SensorData/Garbeg_data/Data_MaskMeterial(polypropylene)_17.11.2025/sensor_data1.csv

Temperature (°C) | Humidity (%) | Paper Sensor Value
26.20 | 58.00 | 6
26.20 | 58.00 | 7
26.20 | 58.00 | 6
26.20 | 59.00 | 8
26.20 | 59.00 | 8
26.20 | 59.00 | 7
26.20 | 60.00 | 7
26.20 | 60.00 | 6
26.20 | 61.00 | 7
26.20 | 61.00 | 7
26.20 | 62.00 | 8
26.20 | 62.00 | 5
26.20 | 63.00 | 6
26.20 | 64.00 | 6
26.20 | 66.00 | 4
26.20 | 67.00 | 6
26.20 | 69.00 | 8
26.20 | 70.00 | 7
26.30 | 72.00 | 6
26.70 | 73.00 | 5
26.70 | 74.00 | 5
26.70 | 77.00 | 7
26.70 | 79.00 | 8
26.70 | 81.00 | 4
26.70 | 83.00 | 7
27.10 | 85.00 | 6
27.10 | 88.00 | 7
27.20 | 90.00 | 3
27.60 | 92.00 | 0
28.00 | 93.00 | 0
28.50 | 94.00 | 0
28.50 | 95.00 | 0
28.90 | 96.00 | 0
29.30 | 98.00 | 0
29.30 | 98.00 | 0
29.80 | 98.00 | 0
29.80 | 98.00 | 0
29.80 | 98.00 | 0
29.80 | 98.00 | 0
29.80 | 98.00 | 0
29.80 | 98.00 | 0
29.80 | 98.00 | 0
29.80 | 98.00 | 0
29.80 | 98.00 | 0
29.80 | 98.00 | 0
29.80 | 98.00 | 0
29.80 | 98.00 | 0
29.80 | 98.00 | 0
29.70 | 98.00 | 0
29.30 | 98.00 | 0
29.30 | 98.00 | 0
29.30 | 98.00 | 0
29.20 | 98.00 | 0
28.90 | 98.00 | 0
28.90 | 98.00 | 0
28.90 | 98.00 | 0
28.50 | 98.00 | 0
28.50 | 98.00 | 0
28.50 | 98.00 | 0
28.50 | 98.00 | 0
28.00 | 98.00 | 0
28.00 | 98.00 | 0
28.00 | 98.00 | 0
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
