RaunakR16/BreathEZ_Auto_CalibratingCPAP/SensorCalibration/SensorData/Garbeg_data/odbhut_data_day_2/sensor_data_R0_230k.csv

Temperature (°C) | Humidity (%) | Sensor Value
24.1 | 41 | 166
24.1 | 41 | 291
24.1 | 41 | 218
24.1 | 41 | 0
24.1 | 41 | 242
24.1 | 41 | 419
24.1 | 41 | 56
24.1 | 41 | 51
24.1 | 41 | 461
24.1 | 41 | 258
24.1 | 41 | 0
24.1 | 41 | 382
24.1 | 41 | 335
24.1 | 41 | 0
24.1 | 41 | 316
24.1 | 41 | 358
24.1 | 41 | 0
24.1 | 41 | 282
24.1 | 41 | 447
24.1 | 41 | 0
24.1 | 41 | 240
24.1 | 41 | 419
24.1 | 41 | 6
24.1 | 41 | 210
24.1 | 41 | 426
24.1 | 41 | 27
24.1 | 41 | 158
24.1 | 41 | 467
24.1 | 41 | 55
24.1 | 41 | 157
24.1 | 41 | 343
24.1 | 41 | 314
24.1 | 42 | 339
24.1 | 42 | 0
24.1 | 42 | 309
24.1 | 42 | 200
24.1 | 42 | 0
24.1 | 42 | 409
24.1 | 42 | 101
24.1 | 42 | 171
24.1 | 42 | 429
24.1 | 42 | 0
24.1 | 42 | 439
24.1 | 42 | 193
24.1 | 42 | 84
24.1 | 42 | 460
24.1 | 42 | 0
24.1 | 42 | 389
24.1 | 42 | 261
24.1 | 42 | 34
24.1 | 42 | 467
24.1 | 42 | 0
24.1 | 42 | 418
24.1 | 42 | 162
24.1 | 42 | 164
24.1 | 42 | 404
24.1 | 42 | 0
24.1 | 42 | 409
24.1 | 42 | 0
24.1 | 42 | 328
24.1 | 42 | 109
24.1 | 42 | 229
24.1 | 42 | 67
24.1 | 42 | 45
24.1 | 42 | 486
24.1 | 42 | 0
24.1 | 42 | 473
24.1 | 42 | 67
24.1 | 42 | 323
24.1 | 42 | 116
24.1 | 42 | 223
24.1 | 42 | 59
24.1 | 42 | 0
24.1 | 42 | 485
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
