RaunakR16/BreathEZ_Auto_CalibratingCPAP/PCB_V0.1/PCB_Schematics.pdf

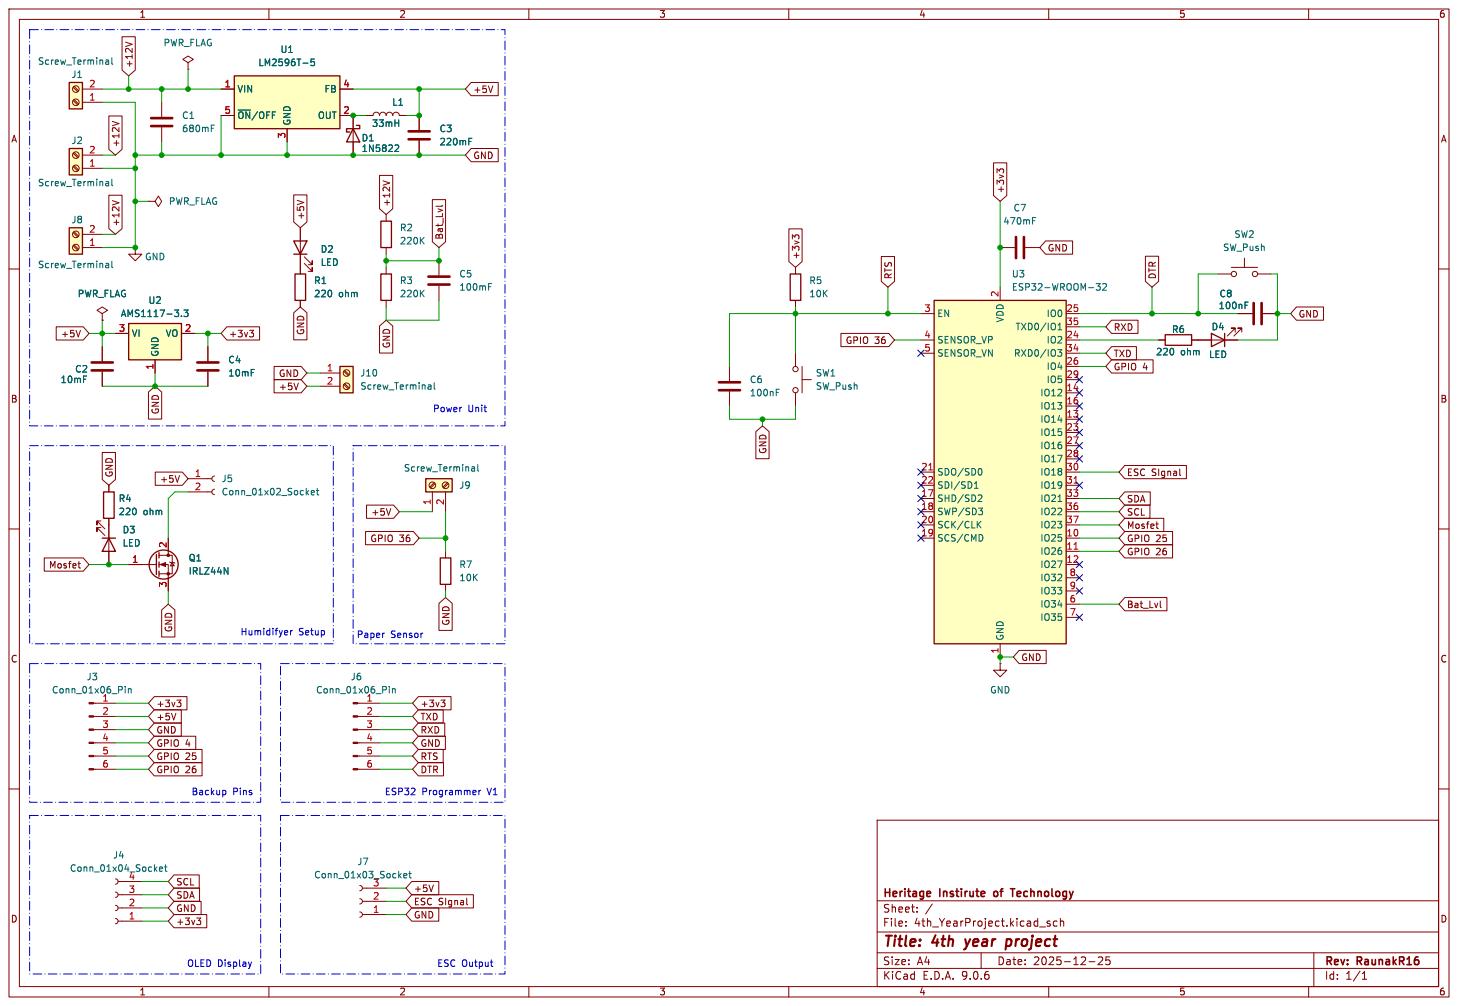
[picture p92: page 1]
