RaunakR16/BreathEZ_Auto_CalibratingCPAP/IMAGES/tank/tank_amb.jpg

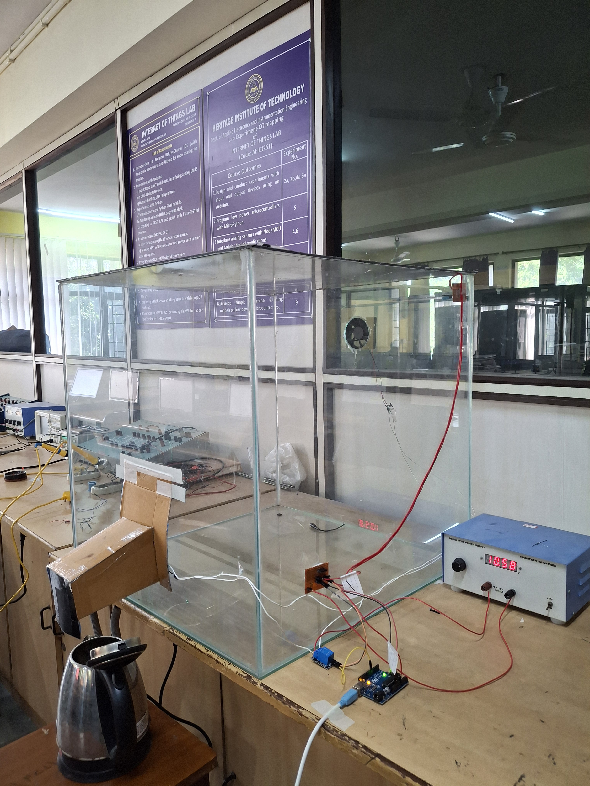
IMAGES/tank/tank_amb.jpg
